donnaware/ZBC---The-Zero-Board-Computer/(threads)

Thread 2 (2019-11-28):

Update DOSey

Freiwind, 2019-11-28:
DOSey has a small bug.
Pressing the "Set the BIOS File" button calls up the same handler as clicking the "Set the FPGA RBF Configuration File" button.
I fixed it.

[controller.zip](https://github.com/donnaware/ZBC---The-Zero-Board-Computer/files/3900493/controller.zip)

Freiwind, 2019-11-28:
Also, could you attach the BOM file.
Otherwise, it is not clear which elements are used.
For example, U11 or SMD Osc, PIC18F2550 or PIC18F2450.

donnaware, 2019-11-28:
Thank you for your interest in this project.  It was from a long time ago for me but now i am remembering it better.  There are a lot of things i probably would do differently today since i have learned more since thing. I think the Dosey program is clumbsy, i would have made a better flashing program now :) Thanks for fixing it, i am glad you are having good luck with it.

I uploaded the BOM, there are also details under the design folder, there is a a doc file and pdf version of it that i hope can help answer some questions as well.  I am happy to provide more details on parts if you need, i have datasheets on most of the parts but I think you can google most of them from the part number i put in the BOM.  I think you could probably use PIC2450 but i used the 2550.

If i were to do it over again i would probably leave out the PIC and implement everything on the FPGA but back then there were a few things i wasnt as good at on the FPGA so i resorted to the PIC.

Feel free to ask more questions i will try to answer them as soon as i can.

Godo Luck !

Freiwind, 2019-11-28:
Thanks!
There are a couple of questions.
40 MHz or 50 MHz crystal oscillator? If look at the code on Verilog, it seems that need a 50 MHz oscillator.
As MAX232 is meant MAX3232 in TSSOP package?

donnaware, 2019-11-28:
I used a 50Mhz oscillator but you could use anything but would have to change the PLL or divider.
Yes I used a MAX3232 16 pin TSSOP SMD, it has a small form factor but really any RS232 level shifter will work just check the pin outs.

Freiwind, 2019-11-29:
I have a PCB, so I plan to solder it.
Purchased here: https://chipkin.ru/product/751/
This PCB has small changes compared to the original.
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

Freiwind, 2019-11-29:
By the way, BAT54CV datasheet have different internal structure than on your concept.
On my PCB is set 4 pieces BAT54SW.
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

donnaware, 2019-11-29:
Oh wow i didnt know there was a PCB for it !

on the shotkey diodes, right, sorry I used the QSBT40 instead because it was a smaller package,
https://www.mouser.com/productdetail/diodes-incorporated/qsbt40-7-f?qs=ZfoJYdGzejEf16A9oiIMXQ%3D%3D

here is my order list from mouser
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

Freiwind, 2019-12-03:
Thanks!
FLASH-memory must be 4MByte x 8? Can I install SST25VF032 or SST25VF016?

Freiwind, 2020-01-31:
Hello!
I finally soldered the circuit board.
How and what program to the PIC controller? It is already soldered on the board.
I did not find a HEX file for it.

donnaware, 2020-02-01:
Hi Freiwind,

Sorry if I did not post the hex file, it was an oversight on my part.  I was using the PIC as a USB bridge mainly for uploading firmware and etc.

It is now posted on Github, it is under src/pic in the repository.

There is a flash memory that holds the firmware and you upload to it over USB and then the unit can boot up even if not connected to the PC or you can test out things by having it boot over the USB, that allows you to test out things without flashing the flash memory.  If I were to do the design over again I think I would have left the pic off the board and had it as a separate programming dongle but it is handy to have it on board too.  But I think at the time I thought that the A/D converts built into the PIC would be handy to have.  Also I put the RTC on the PIC which I now think was a less than optimal choice I can’t recall why I did that I think it would have been better to have it directly connected to the FPGA I think I had a reason for that but I don’t recall now.

I included the source code as well in case you want to make changes to the pic code, it was compiled in the CCS C compiler, it could probably be ported to another compiled but it could be tricky to do because of the USB libraries that I used that come with the CCS C compiler.   There is also a PIC18F2450 version which is a cheaper chip

Also, sorry that it takes me a while to respond, I don’t check email often enough 😊

Good luck !

Donnaware

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

Freiwind, 2020-04-26:
Unfortunately, it was not possible to revive the device.
The configuration and BIOS are poured into the Flash ROM, but the system does not start. The SD card is not accessed.
Are there any test configurations for checking board components?

donnaware, 2020-05-01:
Hi Freiwind,

Sorry you are having trouble.  Below is a picture of mine booting up without the SD card.   If the SD card is not present it will boot up by default to the floppy image on the flash ram.

A couple of things to check, on the Setting tab of the configure program, there is a box  MCU Test LED.  If you click on that on and off a RED led over by the MCU config port will flash on and off.  Also you can enable the logger on the USB tab click show USBHID Logger.  These two things will insure that the pic mcu is communicating with your pc.  If it is not flashing then try the mcu reset button and see if that helps.

Once you confirm comm is working to your PC then try under setting tab click and unclick reset FPGA.  You can also try uploading the zbc.rbf file over the com link rather than from flash. Also, I uploaded an update to the config program that makes finding the bios.rom file easier.  I also included the zbc.rbf and bios.rom and the dos image files in the controller folder. I also put a file BlinkLED.rbf which, if you upload that using the set fpga option then use the upload rbf config directly to fpga it will blink a green LED on the FPGA so show the FPGA config is working.

I down loaded the zbc.rbf, bios.rom and F-DOS5.img From my github and reflashed my board and booted it. The F-DOS5.image is a dos 5 floppy image. If you leave the sd card out it will boot off that as a default.

I hope this helps !

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

Freiwind, 2020-05-03:
Hi!
I tried to download BlinkLED.rbf. The LED blinks, everything is fine.
PIC also works correctly, as I understand it.
After loading zbc.rbf, bios.rom and a disk image, the device responds to the SW3 button. The SW1 button restarts the entire device. When I press and release the SW3 button, the EP3S16 configuration reloads. The LED next to the SW3 button flashes for one second. A signal appears on the VGA, but without any information on the display.
This is the state with and without an inserted SD card.
I tried to install SST25VF016B and SST25VF032B.
The reaction is the same.
