donnaware/ZBC---The-Zero-Board-Computer/(list of files, drawings)

Other design files:
pcb/ZBC (16KLE) Rev1A (Fixes).pcb
