donnaware/ZBC---The-Zero-Board-Computer/src/mcu/SPIFPGA.h

//==============================================================================
//==============================================================================
// SPI  FPGA Controler Routines                                        SPIFPGA.H
//
// This driver controls the FPGA via an SPI interface. These are the low level
// driver routines to access the FPGA functions.
//
// DonnaWare International LLP Copyright (2001) All Rights Reserved        
//==============================================================================
//==============================================================================


//------------------------------------------------------------------------------
//------------------------------------------------------------------------------
// Library for FPGA SPI Interface                              
//
// void FGPA_SPI_Init()  - Initializes the pins that control the device.   
// int  SPI_xferByte()  - Writes and Reads a register from the device                     
//                                                               
//   Pin Assignments:                         
//   SSEL    Device Select  
//   MOSI    Device Data Oout   
//   SCK     Device Clock              
//   MISO    Device Data Input              
//
//   #define DEVICE_SELECT       PIN_xx        // Device /CS
//   #define DEVICE_CLOCK        PIN_xx        // Device Clk
//   #define DEVICE_DO           PIN_xx        // Device to PIC
//   #define DEVICE_DI           PIN_xx        // PIC to Device
//
//------------------------------------------------------------------------------
//------------------------------------------------------------------------------
#define DEVICE_SELECT   MC_SSEL     // Device /CS
#define DEVICE_CLOCK    MC_CLOCK    // Device Clk
#define DEVICE_DI       MC_MISO     // PIC to Device
#define DEVICE_DO       MC_MOSI     // Device to PIC
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
