donnaware/ZBC---The-Zero-Board-Computer/(commit log)

2010-08-29 This is the initial load of ZBC
    Just starting the repository
    [ZBC (16KLE) Rev1A (Fixes).pcb, ZBC (16KLE) Rev1A (Fixes).sch]
2010-09-01 Updates to design files
    [ZBC (16KLE) Rev1A (Fixes).sch]
2019-11-23 Added missing pic.v
    pic.v priority interrupt controller Verilog file
    [pic.v]
2019-11-28 BOM file
    Bill of material file added
2019-11-29 Corrected shotkey diode part #
